mogli91/robot-competition/report/rc07.tex

%%%%%%%%%%%%%%%%%%%%%%%%%%%%%%%%%%%%%%%%%%%%%%%%%%%%%%%%%%%%%%%%%%%%%%%%%%%%%%%%
%
%   Semester project, fall term 2014
%   Author: Jakob Ehrl, born 01/24/91
%   Study program: Computer science, MA 1
%   
%   Professor Dr. Francesco Mondada
%   Assistant: Dr. Stefan Witwicki
%
%%%%%%%%%%%%%%%%%%%%%%%%%%%%%%%%%%%%%%%%%%%%%%%%%%%%%%%%%%%%%%%%%%%%%%%%%%%%%%%%%

\chapter{Schematics and Implementation}

In this section is described the connection between the different modules, voltage sources, and the signal cables.

\section{Modules connection}

The main modules are connected together, with a central processing brain, the Odroid-C1.

\begin{figure}[H]
  \centering
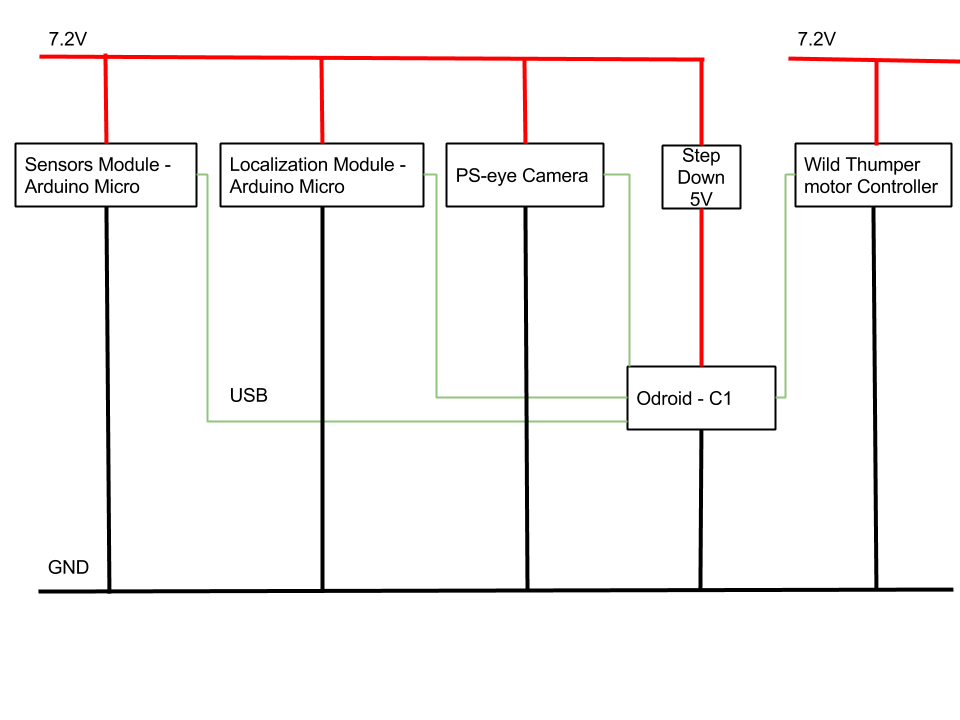
[picture p27: report/figures/GlobalConnection.png]
  
  \caption{The Global abstract connection between the different modules.}
\label{fig:GlobalConnection}
\end{figure}

In the Figure \ref{fig:GlobalConnection} above, is represented the connection diagram between the main modules. As it can be observed, the communication connections between these modules are all USB ( green wire) . This will reduce the number of cables, and ease the communication, as it is an asynchronous protocol, which is widely used and very documented for the arduinos and odroid.\\

Everything is supplied by two battery packs of 7.2 Volts, but have a common ground. The reason for decoupling the wild thumper power supply from the rest comes from the high demand in current required for the motors. This current flow can (if higher than the 10 A of the fuse) burn the fuse for in the power rack. Another reason is that the motors draw much current (2.2 Amps per motor at stall) and if the odroid is connected to the same battery it can happen that the current instability will cause the odroid to fail.

The odroid is connected to a step down voltage regulator, because it needs a stable 5 volts power supply to function correctly.

\section{Sensor Module}

The sensors module, as described in it's respective section, is connected to all the range sensors in the robot. It can also control the brush motor and the Dynamixel smart Servo. An other feature is to read the current that is flowing through the brush motor.

\begin{figure}[H]
  \centering
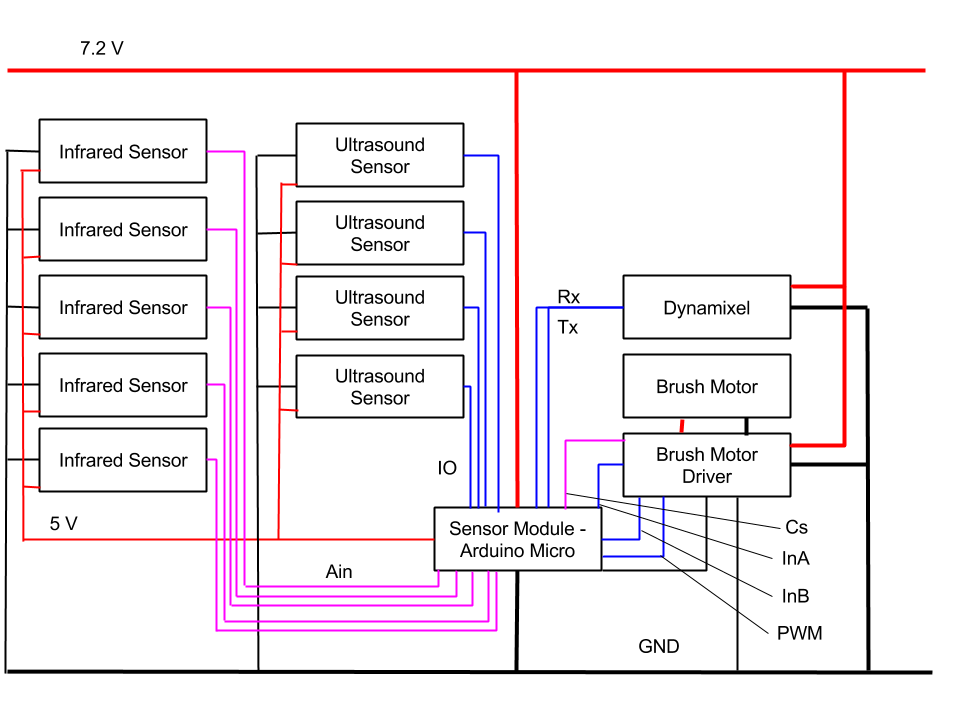
[picture p28: report/figures/Arduino1Connection.png]
  
  \caption{The Sensors module, and it's connections.}
\label{fig:ard1connection}
\end{figure}

As it can be seen in Figure \ref{fig:ard1connection} above, the sensors module is connected to many different sensors. With 20 IO pins and 12 Analog input pins, the arduino Micro is also powerful enough to read, interpred, and connect to all those sensors. In purple are all the analog wires, and blue the IO pins. The Cs is a special pin on the motor driver that allows to read the current flowing through the motor. Each 140mV read on this pin corresponds to 1 Amp on the motor. For the dynamixel, as described earlier, the two serial wires are connected together with a resistance in between to simulate a half duplex connection. The ultrasound sensors, as well have both echo and ping pins connected together with a resistance in between, in order to reduce the number of pins used on the arduino micro, and facilitate the connections.\\

The three other IO pins connected to the motor driver are just controls for the motor. The motor driver needs two power supplies. One is for the input logic, 5V, and the other is for the motor output (we used the battery 7.2 V power supply).\\

Figure \ref{fig:ard1connection} was the planned connections, but was not what was used in the end, during the competition, a more accurate figure would be Figure \ref{fig:ard1connection2} seen below, where only infrared sensors were used.

\begin{figure}[H]
  \centering
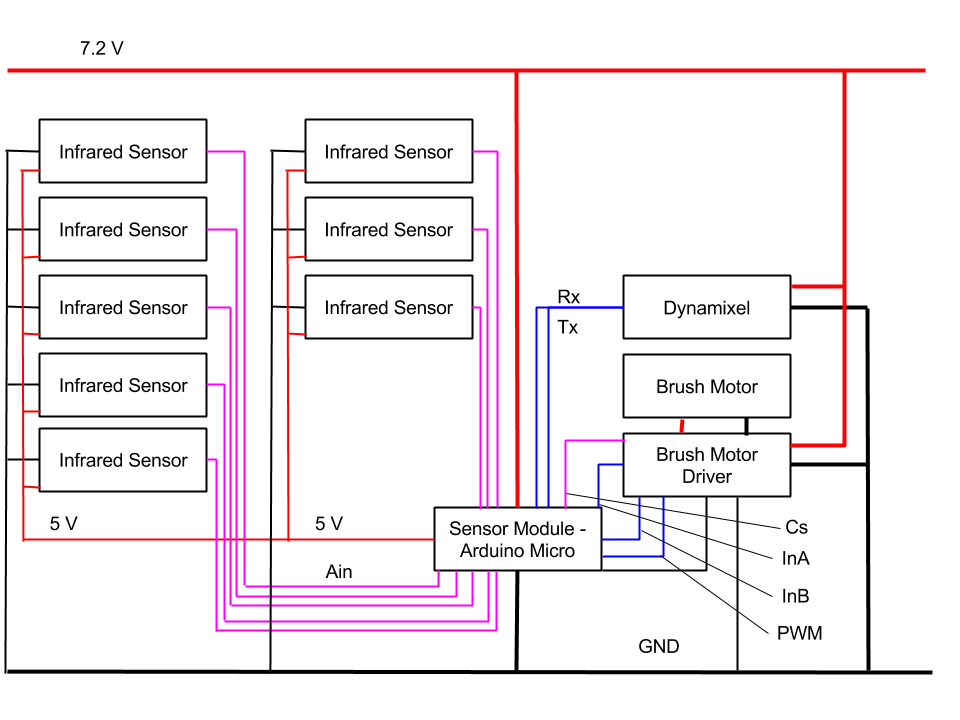
[picture p29: report/figures/Arduino1Connection2.png]
  
  \caption{The Sensors module, and it's connections.}
\label{fig:ard1connection2}
\end{figure}

\section{Localization Module}

The localization module is, as described in the section previously, the module that uses 6 line sensor arrays and a compass to locate the position and yaw of the robot. 

\begin{figure}[H]
  \centering
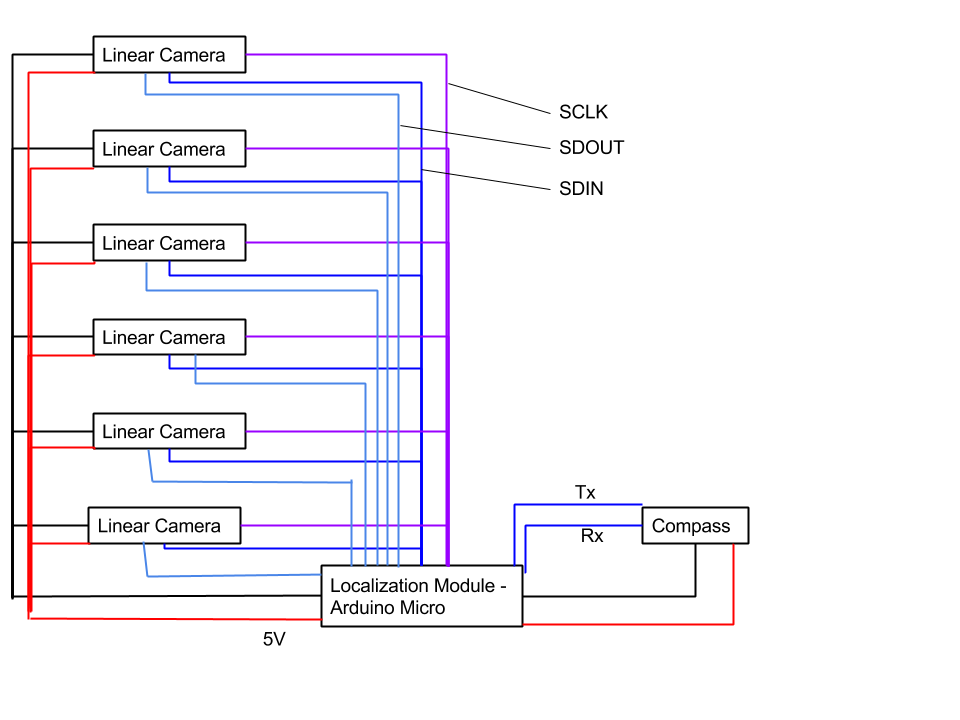
[picture p30: report/figures/Arduino2Connection.png]
  
  \caption{The Localization module, and it's connections.}
\label{fig:ard2connection}
\end{figure}

The connection between the arduino micro and the sensors is shown in the Figure \ref{fig:ard2connection} above. The compass uses a simple serial connection, and the arduino micro has two of them ( USB and serial pins). For the linear cameras, three lines were necessary. SCLK, the clock, can be common between the sensors, since it does not have any effect if no data is transmitted. %The SDIN lines are soldered together as well, XXXXXXXXXXXXXXXXXXXXXXXXXXXXXXXXXXXXXXXX
%XXXXXXXXXXXXXXXXXXXXXXXXXXXXXXXXXXXXXXXXXXX
%XXXXXXXXXXXXXXXXXXXXXXXXXXXXXXXx
%XXXXXXXXXXXXXXXXXXXXXXXXXXXXXXX
%XXXXXXXXXXXXXXXXXXXXXXXXXXXXXXX

\section{Motor driver module}

The motor driver module has very simple connections. The only devices it is controlling are the motors, and the tailgate servo.

\begin{figure}[H]
  \centering
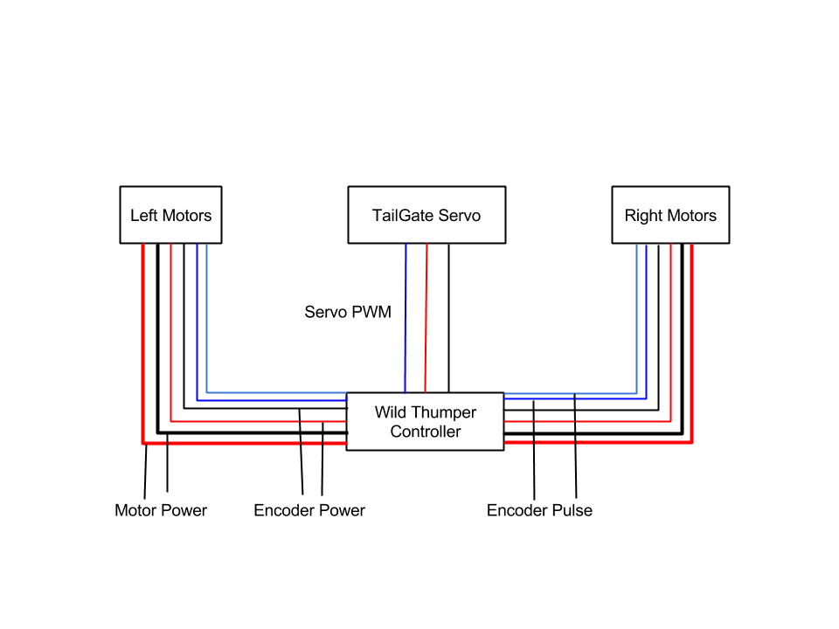
[picture p31: report/figures/WildThumperConnection.png]
  
  \caption{The Motor Driver Module, and it's connections.}
\label{fig:wtconnection}
\end{figure}

Seen in Figure \ref{fig:wtconnection} above is the connection diagram of the wild thumper motor controller. The only signals it is reading are the motor encoders, which allow to estimate a precise speed, and position of the wheels.

%\chapter{Implementation}
%how everything was connected, connectors etc.. battery... 

\chapter{Results}
The robot was the second one in the competition. With 2.5 poits, the robot was able to capture a bottle and nearly bring it back in time. The remote control from a computer allowed us to control manually all the functions of the robot, the wheels, the servos, and the brush, and we were also able to visualize the camera, and see the values of all the different sensors. The robot was able to navigate towards a bottle, to avoid obstacles, and was also able to return home and open the tailgate. However, as many false positives were measured from the camera, the robot sometimes saw beacons, and thus released the bottles. Another feature was area distinction, which allowed the robot to avoid going in dangerous zones, but there, once again, the false positives would make the robot go towars the rocks for instance. As the shovel was close to the ground, the robot sometimes got stuck in between the tiles, under the grass or the rocks. In the beginning it was planned to use two dynamixels, because one was not strong enough to just `hover' the lift above the ground, but since the synchronization of the servos failed, we could only have two states : on the ground or lifted all the way.

\chapter{Conclusion and Acknowledgments}

\section{Conclusion}
Finally, this huge project took a tremendous amount of our time. In order to accomplish a functionnal robot, nearly every day was spend in epfl until midnight, where intense work took place. It was quite sad to obtain a robot that did not manage to bring back more than one bottle at the end, especially considering the amount of work invested in the project. However, all this work allowed us to learn very much on the design, construction and programming of a robot, with all the project phases in between, as well as team management, working together and programming together. All the theory behind the building of a robot was already known, but assembling it and testing it gave us a whole new insight about all the problems that can occur during such a large project, and how to deal with them, solve them. Problems that are not only with the hardware, or the software, but also in the group itself. \\

\section{Acknowledgments}
We would like to thank our assistant Tomasz, for all the help and support during the competition, as well as all the other assitants that were always available for some questions. We would like to thank as well Alessandro Crespi, who was always available for purchases, maintenance of the machines, and his advice. We would also want to thank Mr. Lispjeert and all the team behind this semester project, whithout whom it would not be possible. Finally, we would like to thank all the other groups for their support, help, friendliness, all the good times that we had toghether in the lab, and all the barbecues that we had. This competition was for us more of a `friendly' contest between friends, rather than a cold and unfriendly competition. If we could recommend this semester project for future students we would ( and already have...).

\chapter{Annex}

\begin{figure}[H]
  \centering
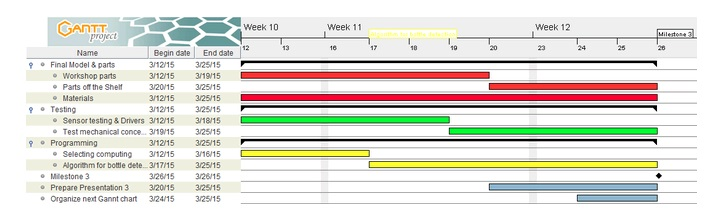
[picture p32: report/figures/GanttChart1.jpg]
  
  \caption{Gannt Chart until the third milestone.}
\label{fig:gannt1}
\end{figure}

\begin{figure}[H]
  \centering
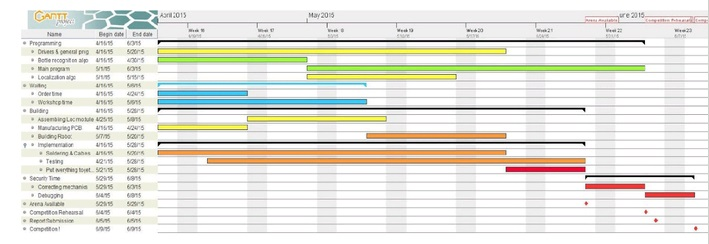
[picture p33: report/figures/GanttChart2.jpg]
  
  \caption{Gannt Chart until the end of the competition.}
\label{fig:gannt2}
\end{figure}

\begin{figure}[H]
  \centering
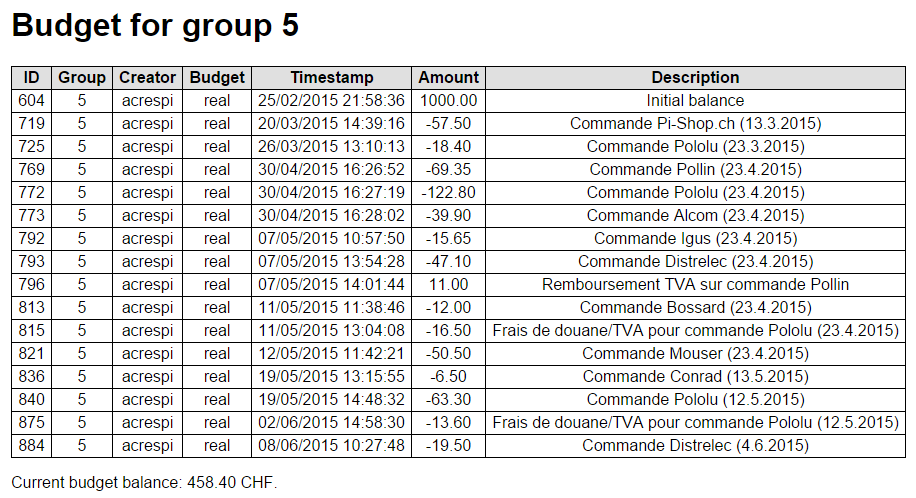
[picture p34: report/figures/budgetreal.png]
  
  \caption{Real budget used for the robot.}
\label{fig:real}
\end{figure}

\begin{figure}[H]
  \centering
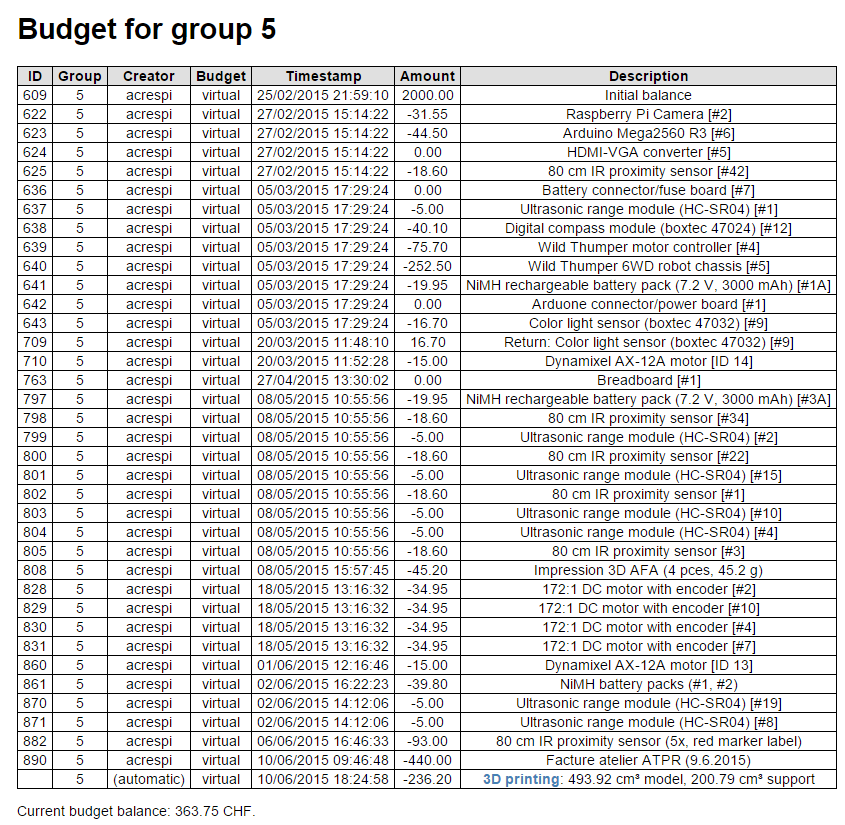
[picture p35: report/figures/budgetvirtual.png]
  
  \caption{Virtual budget used for the robot.}
\label{fig:virtual}
\end{figure}
