mogli91/robot-competition/sketchbook/ArduinoMicro1/Used Pins.txt

Arduino micro - capteurs et moteur

20 pins IO - 7 PWM, 12 AI 

Infrarouges 
IR gauche - A0
IR devant côté gauche - A1
IR devant côté droit - A2
IR droite - A3
IR derrière - A4

Ultrasons
US gauche - pin 2
US devant côté gauche - pin 3
US devant côté droit - pin 4
US droite - pin 5

Moteur de rouleau (driver = https://www.pololu.com/product/1451)
CS (currnt sense - 140mv per amp) - Pin 12 = A11
PWM (motor control) - pin 11
INA (clockwise direction) - pin 9 
INB (counterclocwise direction) - pin 10
ENA - not connected
ENB - not connected
CS_DIS - not connected

Serial connection : 
RX : pin 0
TX : pin 1
