mogli91/robot-competition/report/rc00.tex

%%%%%%%%%%%%%%%%%%%%%%%%%%%%%%%%%%%%%%%%%%%%%%%%%%%%%%%%%%%%%%%%%%%%%%%%%%%%%%%%
%
%   Semester project, fall term 2014
%   Author: Jakob Ehrl, born 01/24/91
%   Study program: Computer science, MA 1
%   
%   Professor Dr. Francesco Mondada
%   Assistant: Dr. Stefan Witwicki
%
%%%%%%%%%%%%%%%%%%%%%%%%%%%%%%%%%%%%%%%%%%%%%%%%%%%%%%%%%%%%%%%%%%%%%%%%%%%%%%%%%

\input{header}

\includeonly{rc01, rc02, rc03, rc04, rc05, rc06, rc07, rc-lit, rc-lof, rc-lot}

\begin{document}

\clearpage
  \begin{deckblatt}
    \Titel{STI Robot competition}
    \NameA{Ehrl}
    \VornameA{Jakob}
    \NameB{Longobardi}
    \VornameB{Pasquale}
    \NameC{Unnervik}
    \VornameC{Eric}
   \Betreuer{Tomasz Gorecki}
    \Start{February 22nd 2015}
    \Ende{June 5th 2015}
  \end{deckblatt}

%\cleardoublepage

\begin{center}
\bfseries
Abstract
\normalfont
\end{center}
This report presents in detail the phases that have brought to the realization of a mobile, autonomous robot conceived to participate to the STI Robot Competition 2015 . This competition aims to allow student at master level to come up with solutions, for a recycling robot for PET bottles collection and transport in a reserved area, dealing with the difficulties coming from a challenging environment such as complex terrains and obtacles. The participation to this competition, as fulfillment of the master’s semester project for our team, involved the complete design of the robotic system in every aspect from hardware to software allowing us to face all the usual challenges that are encountered through the achievement of such a project. The design of the mechanical parts has been coupled with the choice of sensors and actuators exploited by developing algorithms in order to achieve perception, actuation, navigation and localization tasks that gave to the robot the necessary skills to take part in the competition.

%\cleardoublepage
\clearpage

\tableofcontents

%\cleardoublepage
\clearpage

\pagenumbering{arabic}

\include{rc01}   
%\cleardoublepage
%\clearpage
\include{rc02}   % (\chapter{})
%\cleardoublepage
\include{rc03}   % (\chapter{})
%\cleardoublepage
\include{rc04}   % (\chapter{})
%\cleardoublepage
\include{rc05}   % (\chapter{})
%\cleardoublepage
\include{rc06}   % (\chapter{})
%\cleardoublepage
\include{rc07}   % (\chapter{})
%\cleardoublepage
%\include{rc08}   % Zusammenfassung (\chapter{Zusammenfassung}  TEXT)
%\cleardoublepage

%\appendix
%\cleardoublepage
%\include{rc09}   % Glossar (\chapter{Glossar}  TEXT)
%\cleardoublepage
%\include{rc10}   % 
%\cleardoublepage
%\include{rc11}   % 
%\cleardoublepage

\include{rc-lof} % Bilderverzeichnis
%%\cleardoublepage
%%\clearpage
%\include{rc-lot} % Tabellenverzeichnis
%%\cleardoublepage
%%\clearpage
\include{rc-lit} % Literaturverzeichnis

\end{document}
