mogli91/robot-competition/report/tikz-pictures.pdf

i

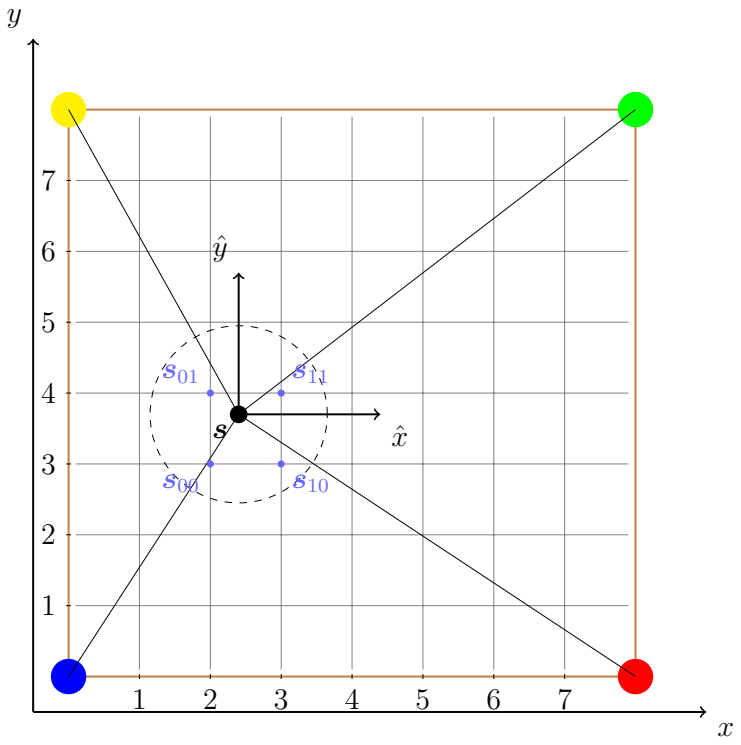
[picture p50: figure]
