mogli91/robot-competition/report/figures/alternative.pdf

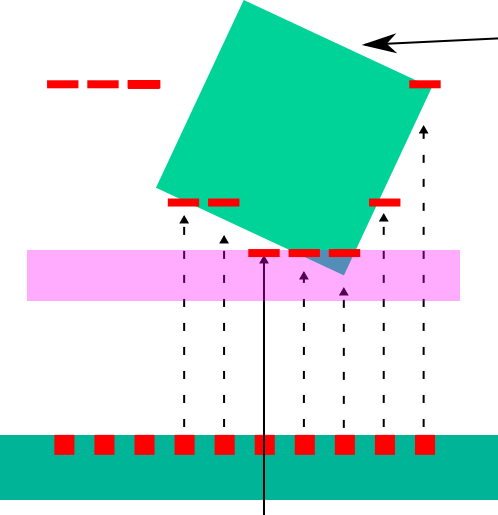
[picture p51: figure]
