mogli91/robot-competition/report/figures/alternative_for_presentation.pdf

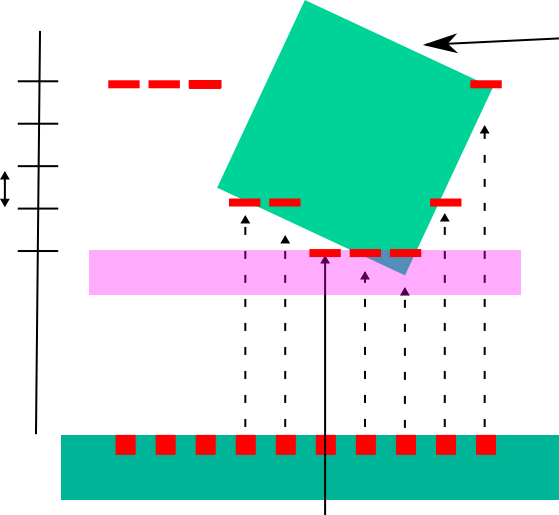
[picture p52: figure]
