mogli91/robot-competition/report/figures/marxbot.pdf

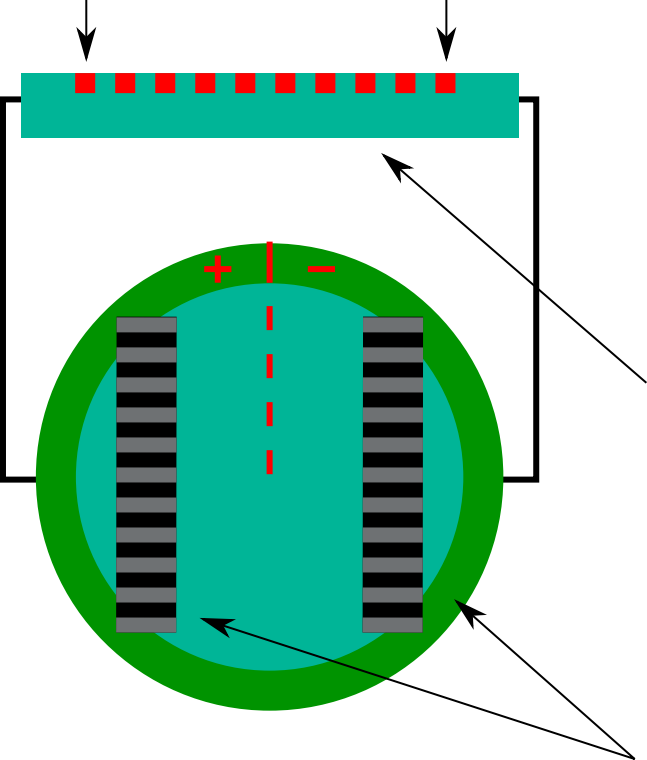
[picture p53: figure]
