mogli91/robot-competition/report/figures/reward.pdf

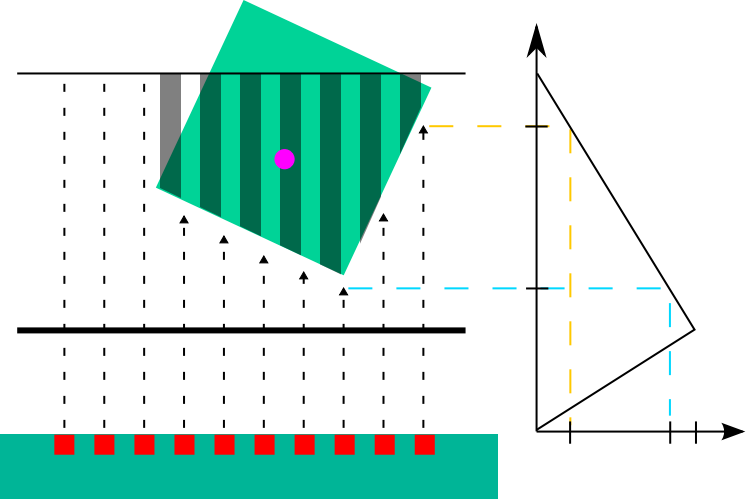
[picture p54: figure]
