mogli91/robot-competition/report/figures/s_min_mu.pdf

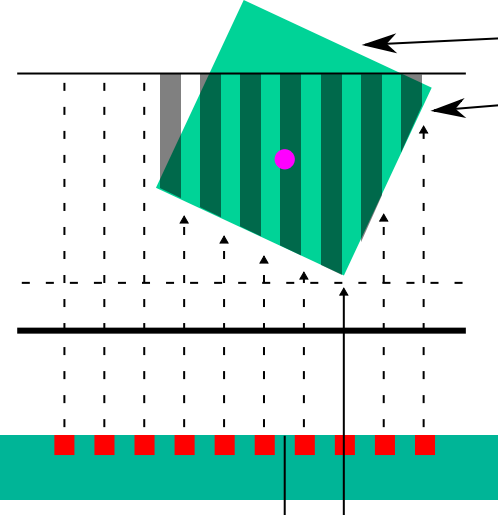
[picture p55: figure]
