mogli91/robot-competition/report/figures/009-mask.png

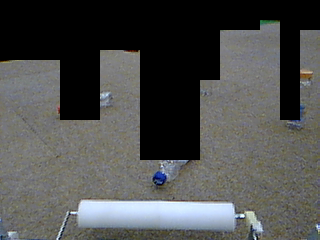
report/figures/009-mask.png
