mogli91/robot-competition/report/figures/AdjustableHeight1.JPG

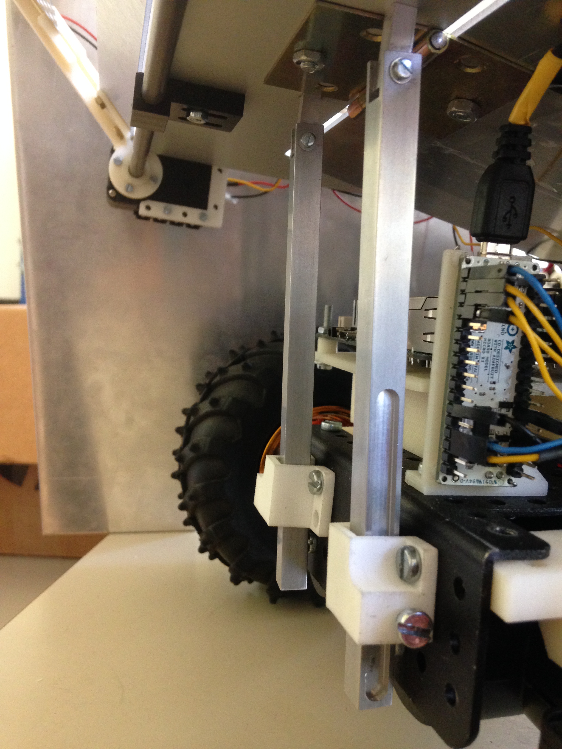
report/figures/AdjustableHeight1.JPG
