mogli91/robot-competition/report/figures/arduino.jpg

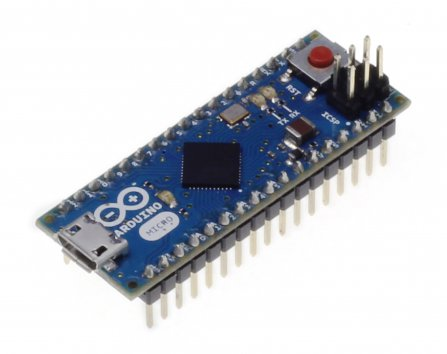
report/figures/arduino.jpg
