mogli91/robot-competition/report/figures/box1.png

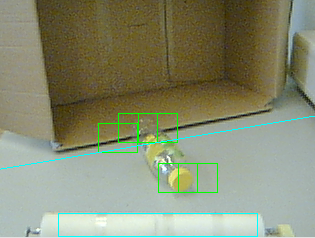
report/figures/box1.png
