mogli91/robot-competition/report/figures/box2.png

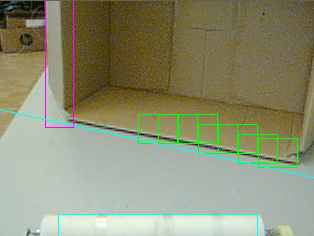
report/figures/box2.png
