mogli91/robot-competition/report/figures/compass.jpg

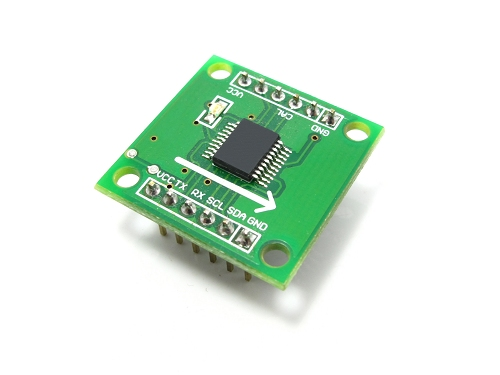
report/figures/compass.jpg
