mogli91/robot-competition/report/figures/connector.jpg

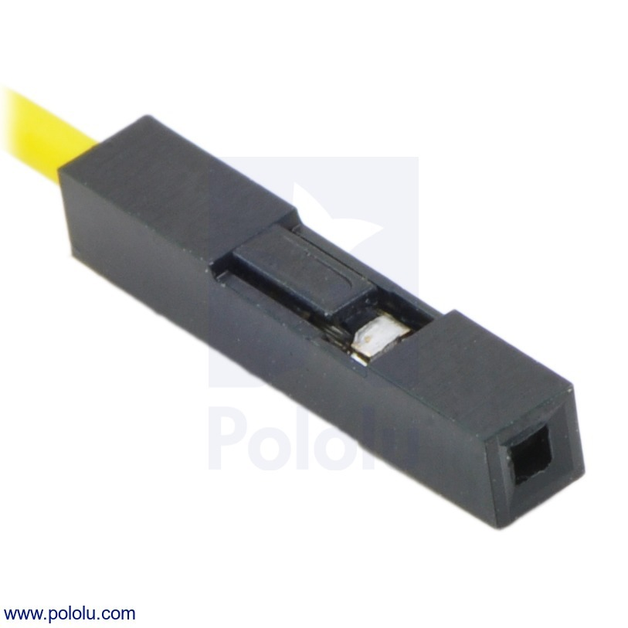
report/figures/connector.jpg
