mogli91/robot-competition/report/figures/FSM.jpg

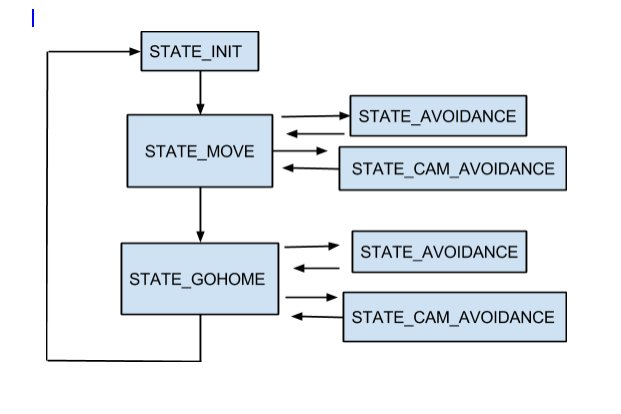
report/figures/FSM.jpg
