mogli91/robot-competition/report/figures/histograms.png

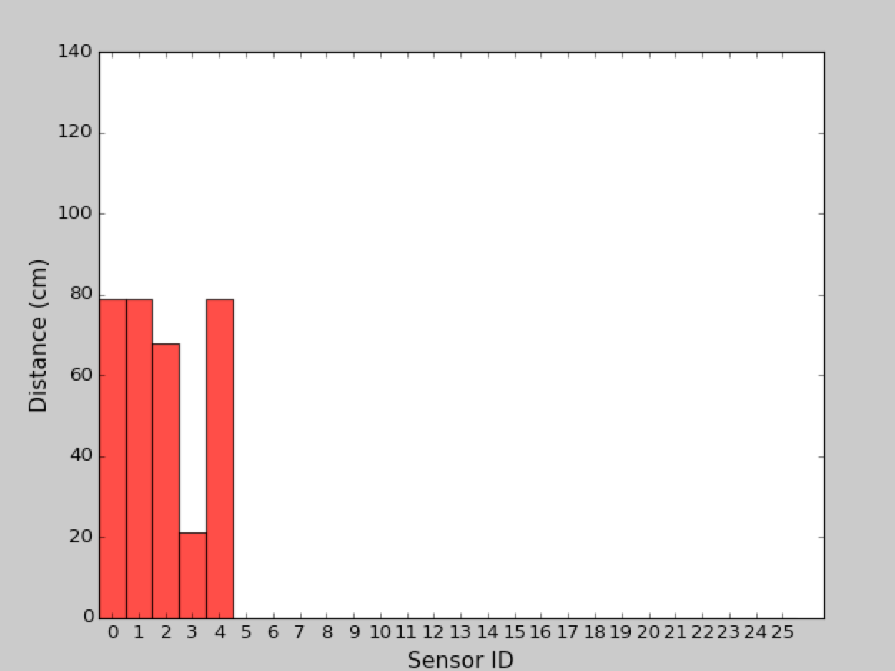
report/figures/histograms.png
