mogli91/robot-competition/report/figures/motor.jpg

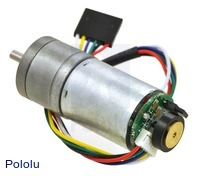
report/figures/motor.jpg
