mogli91/robot-competition/report/figures/pseye.jpg

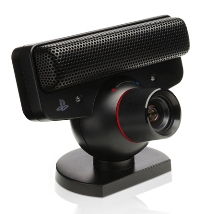
report/figures/pseye.jpg
