mogli91/robot-competition/report/figures/regulator.jpg

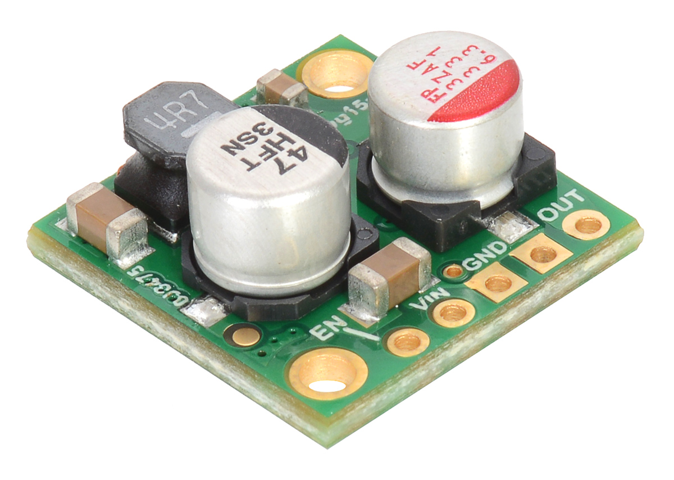
report/figures/regulator.jpg
