mogli91/robot-competition/report/figures/wtc.jpg

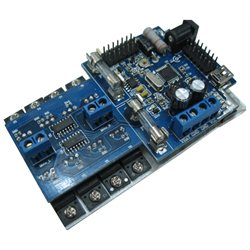
report/figures/wtc.jpg
