mogli91/robot-competition/vision/pics/0001.png

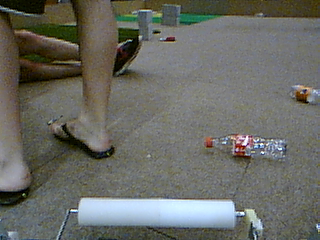
vision/pics/0001.png
