mogli91/robot-competition/vision/pics/0003.png

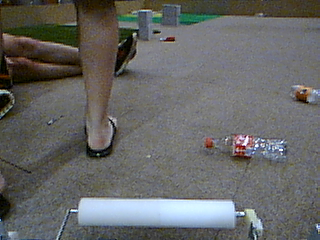
vision/pics/0003.png
