mogli91/robot-competition/vision/pics/0004.png

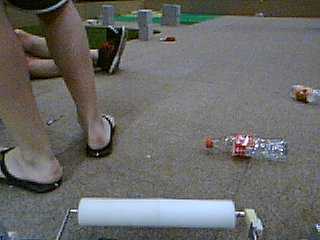
vision/pics/0004.png
