mogli91/robot-competition/vision/pics/0005.png

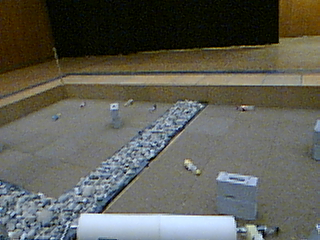
vision/pics/0005.png
