mogli91/robot-competition/vision/pics/0006.png

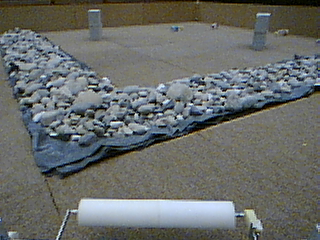
vision/pics/0006.png
