mogli91/robot-competition/vision/pics/0007.png

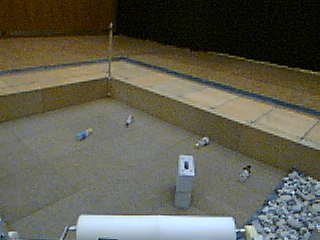
vision/pics/0007.png
