mogli91/robot-competition/vision/pics/0008.png

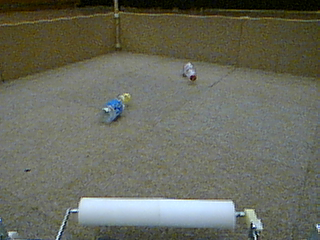
vision/pics/0008.png
