mogli91/robot-competition/vision/pics/0009.png

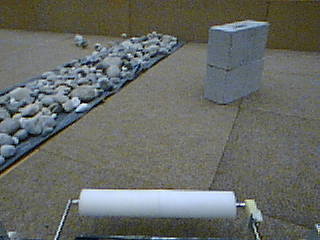
vision/pics/0009.png
