mogli91/robot-competition/vision/pics/0010.png

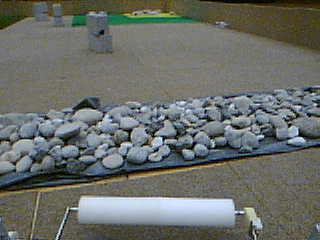
vision/pics/0010.png
