mogli91/robot-competition/vision/pics/0011.png

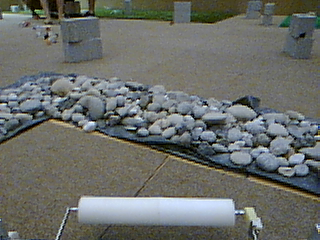
vision/pics/0011.png
