mogli91/robot-competition/vision/pics/0012.png

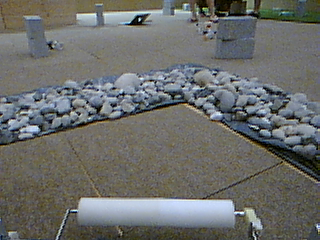
vision/pics/0012.png
