mogli91/robot-competition/vision/pics/0013.png

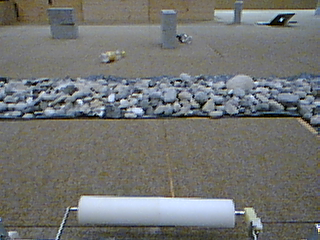
vision/pics/0013.png
