mogli91/robot-competition/vision/pics/0014.png

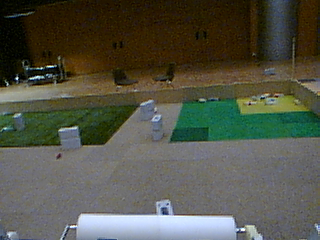
vision/pics/0014.png
