mogli91/robot-competition/vision/pics/0015.png

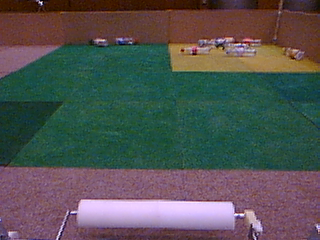
vision/pics/0015.png
