mogli91/robot-competition/vision/pics/0016.png

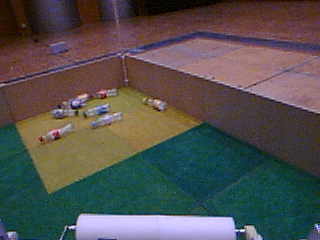
vision/pics/0016.png
