mogli91/robot-competition/vision/pics/0017.png

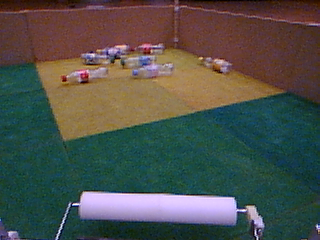
vision/pics/0017.png
