mogli91/robot-competition/vision/pics/0018.png

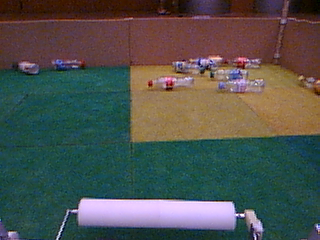
vision/pics/0018.png
