mogli91/robot-competition/vision/pics/0020.png

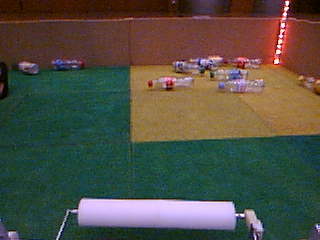
vision/pics/0020.png
