mogli91/robot-competition/vision/pics/0021.png

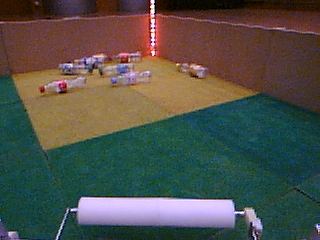
vision/pics/0021.png
