mogli91/robot-competition/vision/pics/0022.png

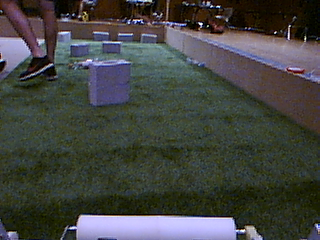
vision/pics/0022.png
