mogli91/robot-competition/vision/pics/0023.png

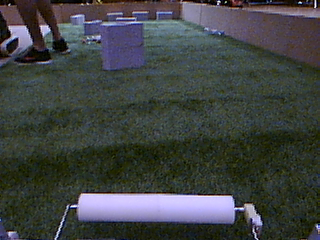
vision/pics/0023.png
