mogli91/robot-competition/vision/pics/0024.png

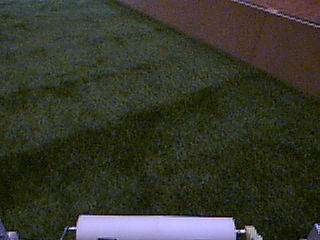
vision/pics/0024.png
