mogli91/robot-competition/vision/pics/0025.png

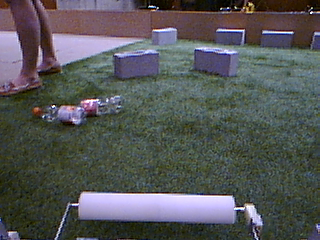
vision/pics/0025.png
