mogli91/robot-competition/vision/pics/0026.png

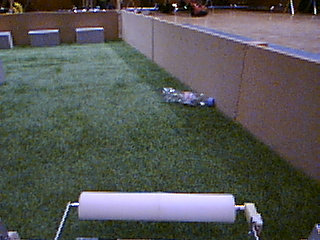
vision/pics/0026.png
