mogli91/robot-competition/vision/pics/0027.png

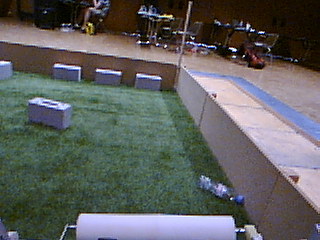
vision/pics/0027.png
