mogli91/robot-competition/vision/pics/0028.png

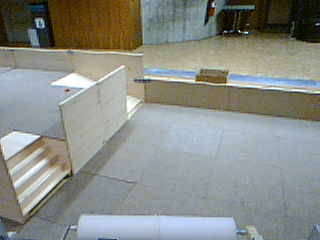
vision/pics/0028.png
