mogli91/robot-competition/vision/pics/0031.png

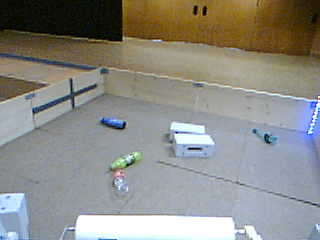
vision/pics/0031.png
