mogli91/robot-competition/vision/pics/0032.png

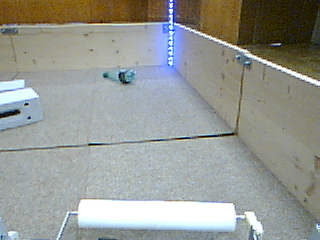
vision/pics/0032.png
