mogli91/robot-competition/vision/pics/0033.png

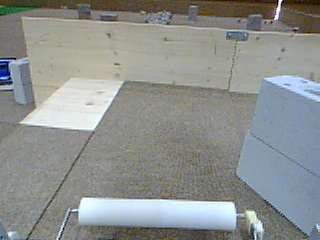
vision/pics/0033.png
