mogli91/robot-competition/vision/pics/0034.png

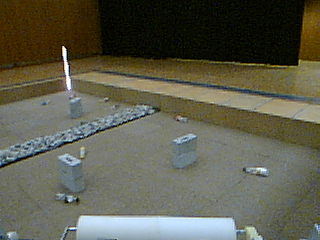
vision/pics/0034.png
