mogli91/robot-competition/vision/pics/0035.png

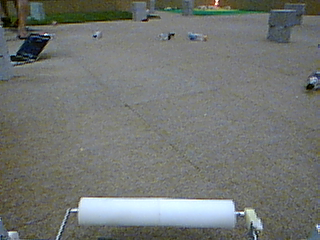
vision/pics/0035.png
