mogli91/robot-competition/vision/pics/0037.png

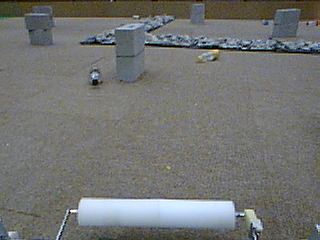
vision/pics/0037.png
