mogli91/robot-competition/vision/pics/0038.png

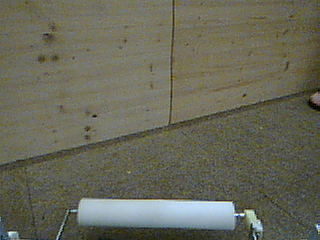
vision/pics/0038.png
