mogli91/robot-competition/vision/pics/0040.png

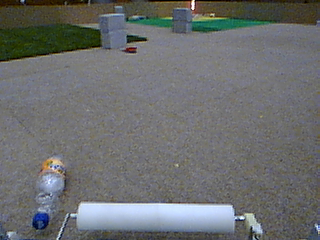
vision/pics/0040.png
