mogli91/robot-competition/vision/pics/0042.png

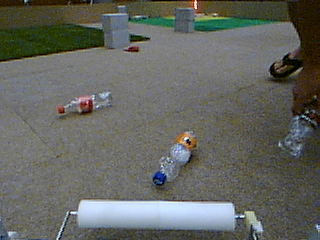
vision/pics/0042.png
