mogli91/robot-competition/vision/pics/0043.png

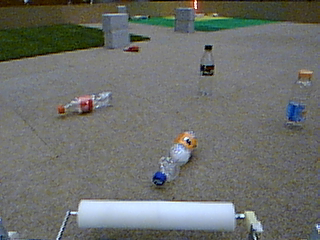
vision/pics/0043.png
