mogli91/robot-competition/vision/pics/0044.png

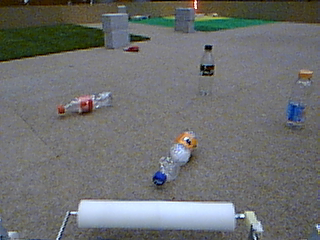
vision/pics/0044.png
