mogli91/robot-competition/vision/pics/guvcview_image-1.jpg

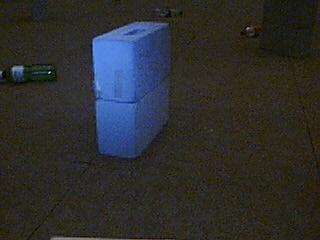
vision/pics/guvcview_image-1.jpg
