mogli91/robot-competition/vision/pics/guvcview_image-3.jpg

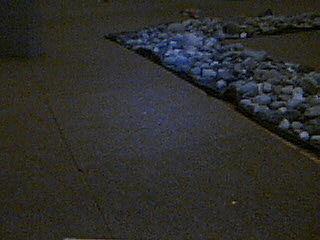
vision/pics/guvcview_image-3.jpg
