mogli91/robot-competition/vision/pics/guvcview_image-4.jpg

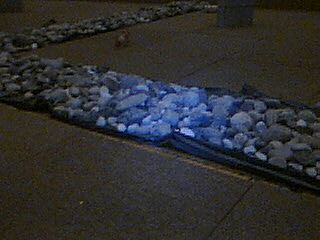
vision/pics/guvcview_image-4.jpg
