mogli91/robot-competition/vision/pics/guvcview_image-5.jpg

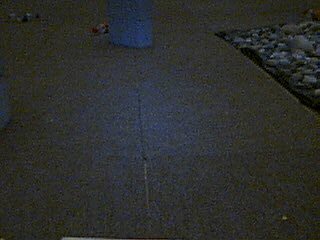
vision/pics/guvcview_image-5.jpg
