mogli91/robot-competition/vision/pics/guvcview_image-6.jpg

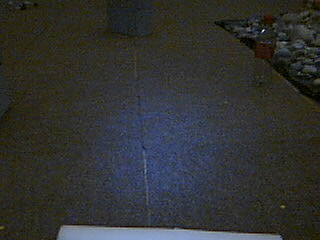
vision/pics/guvcview_image-6.jpg
