mogli91/robot-competition/vision/pics/guvcview_image-8.jpg

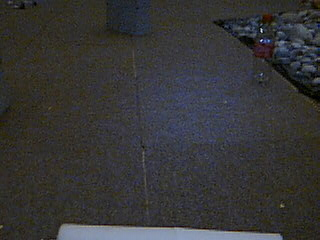
vision/pics/guvcview_image-8.jpg
