mogli91/robot-competition/vision/pics/guvcview_image-9.jpg

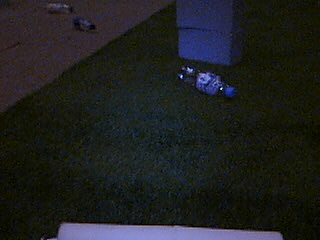
vision/pics/guvcview_image-9.jpg
