mogli91/robot-competition/vision/pics/guvcview_image-10.jpg

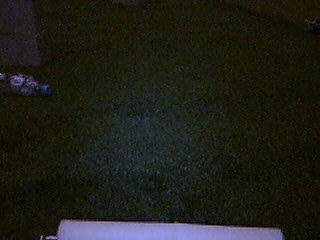
vision/pics/guvcview_image-10.jpg
