mogli91/robot-competition/vision/pics/guvcview_image-12.jpg

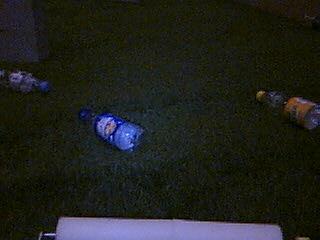
vision/pics/guvcview_image-12.jpg
