mogli91/robot-competition/vision/pics/guvcview_image-13.jpg

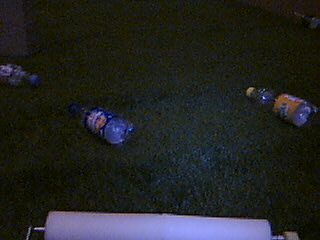
vision/pics/guvcview_image-13.jpg
