mogli91/robot-competition/vision/pics/guvcview_image-14.jpg

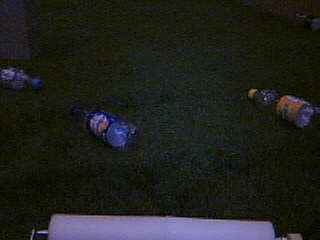
vision/pics/guvcview_image-14.jpg
