mogli91/robot-competition/vision/pics/guvcview_image-15.jpg

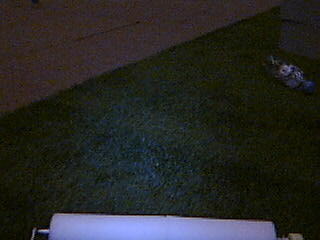
vision/pics/guvcview_image-15.jpg
