mogli91/robot-competition/vision/pics/guvcview_image-16.jpg

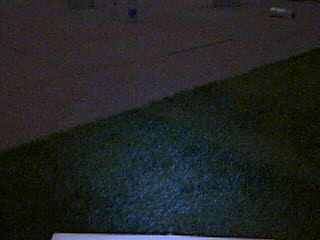
vision/pics/guvcview_image-16.jpg
