mogli91/robot-competition/vision/pics/guvcview_image-17.jpg

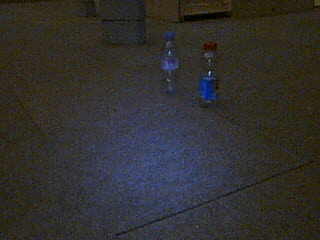
vision/pics/guvcview_image-17.jpg
