mogli91/robot-competition/vision/pics/guvcview_image-18.jpg

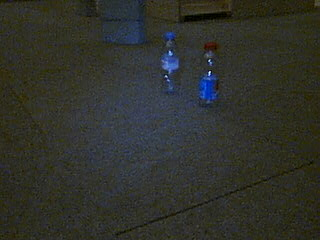
vision/pics/guvcview_image-18.jpg
