mogli91/robot-competition/vision/pics/guvcview_image-19.jpg

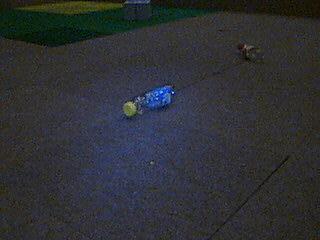
vision/pics/guvcview_image-19.jpg
