mogli91/robot-competition/vision/pics/guvcview_image-21.jpg

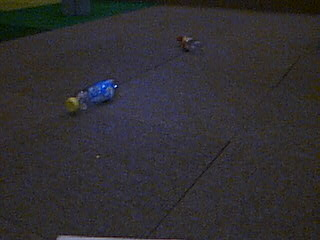
vision/pics/guvcview_image-21.jpg
