mogli91/robot-competition/vision/pics/guvcview_image-22.jpg

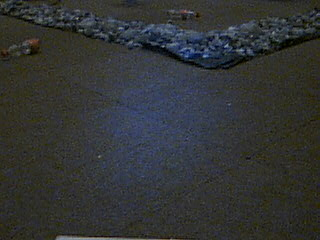
vision/pics/guvcview_image-22.jpg
