mogli91/robot-competition/vision/pics/guvcview_image-23.jpg

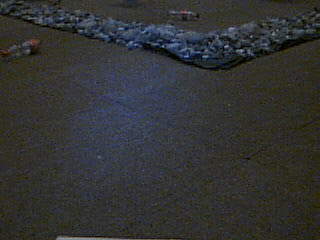
vision/pics/guvcview_image-23.jpg
