mogli91/robot-competition/vision/pics/guvcview_image-24.jpg

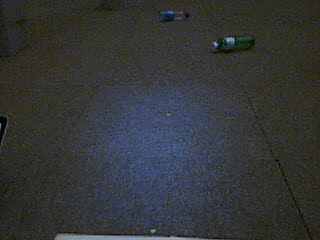
vision/pics/guvcview_image-24.jpg
