mogli91/robot-competition/vision/pics/guvcview_image-25.jpg

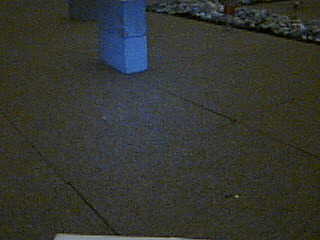
vision/pics/guvcview_image-25.jpg
