mogli91/robot-competition/vision/pics/guvcview_image-26.jpg

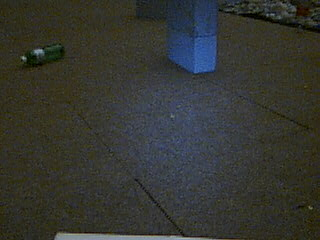
vision/pics/guvcview_image-26.jpg
