mogli91/robot-competition/vision/pics/guvcview_image-27.jpg

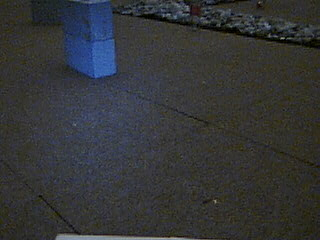
vision/pics/guvcview_image-27.jpg
