mogli91/robot-competition/vision/pics/guvcview_image-28.jpg

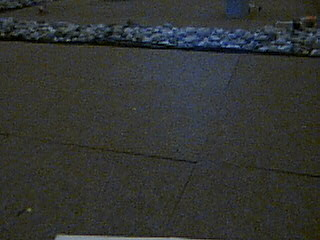
vision/pics/guvcview_image-28.jpg
