mogli91/robot-competition/vision/pics/guvcview_image-29.jpg

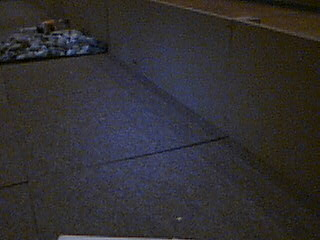
vision/pics/guvcview_image-29.jpg
