mogli91/robot-competition/vision/pics/guvcview_image-30.jpg

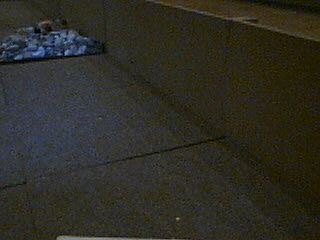
vision/pics/guvcview_image-30.jpg
