mogli91/robot-competition/vision/pics/masked.png

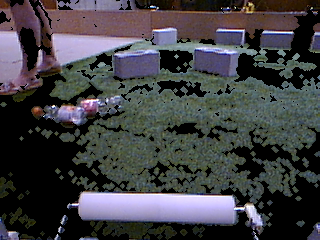
vision/pics/masked.png
