mogli91/robot-competition/report/figures/experiment_plan.pdf

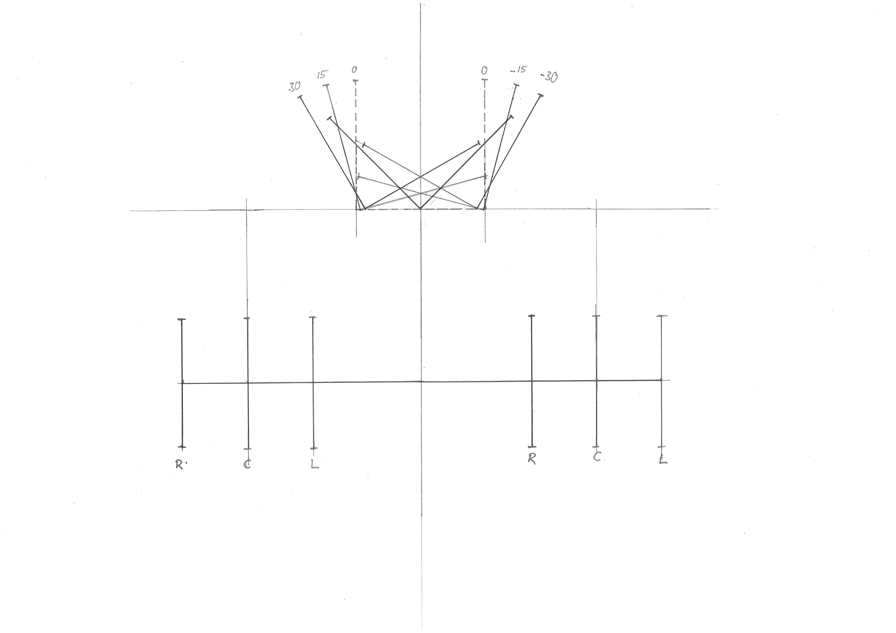
[picture p133: page 1]
