mogli91/robot-competition/report/figures/fig_localization_grid.pdf

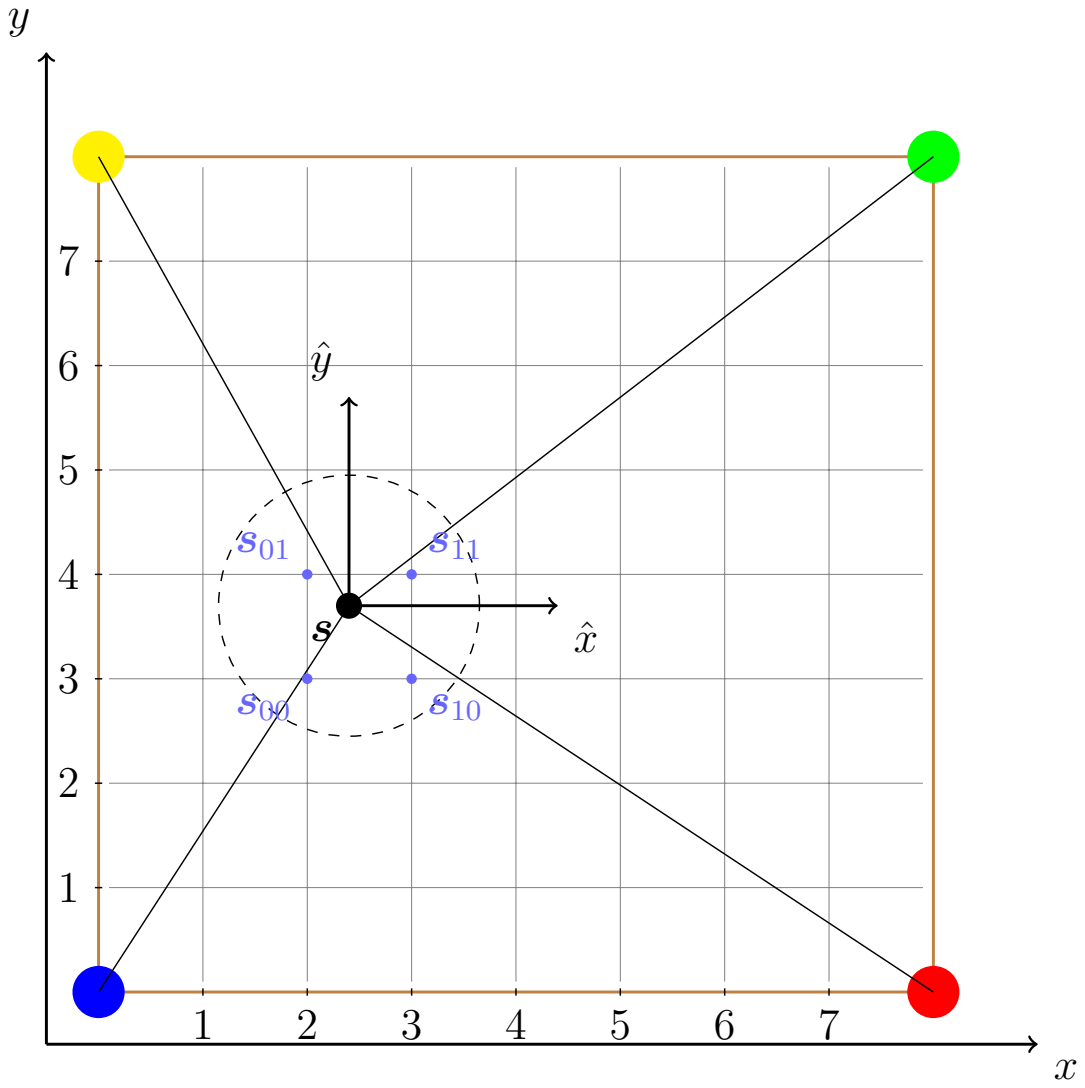
[picture p134: page 1]
