mogli91/robot-competition/sketchbook/WTC/IOpins.h

#define LmotorA             3  // Left  motor H bridge, input A
#define LmotorB            11  // Left  motor H bridge, input B
#define RmotorA             5  // Right motor H bridge, input A
#define RmotorB             6  // Right motor H bridge, input B

#define RCleft              0  // Digital input 0
#define RCright             1  // Digital input 1

#define SERVO               8  // Servo output

#define Battery             0  // Analog input 00
#define RmotorC             6  // Analog input 06
#define LmotorC             7  // Analog input 07
#define Charger            13  // Low=ON High=OFF



/*Wild thumper controller - roues, servos
configuration for the pins : outside = GND middle = VCC (5V) inside = pin

encoders :
left : D12, D10
right : D2, D4

servo :
D8

dynamixel 
D0, D1*/
