mogli91/robot-competition/sketchbook/ArduinoMicro2_Compass/prior.h

#ifndef PRIOR_H
#define PRIOR_H

#include "Arduino.h"

// localization variables
#define NUM_PX 612
#define NUM_BEACONS 4
#define NUM_ANGLES 360

#define WORLDX 800
#define WORLDY 800

#define TILEX 50
#define TILEY 50

const int NUM_X = WORLDX/TILEX + 1;
const int NUM_Y = WORLDY/TILEY + 1;

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

#endif
