mogli91/robot-competition/(commit log)

2015-06-06 pasquale's simulation files and arduino
2015-06-07 obstacle avoidance state machine
    [simulation.cpp, simulation.h]
2015-06-09 timer implemented
2015-06-09 arduino timer function
