mogli91/robot-competition/report/figures/remote.jpg

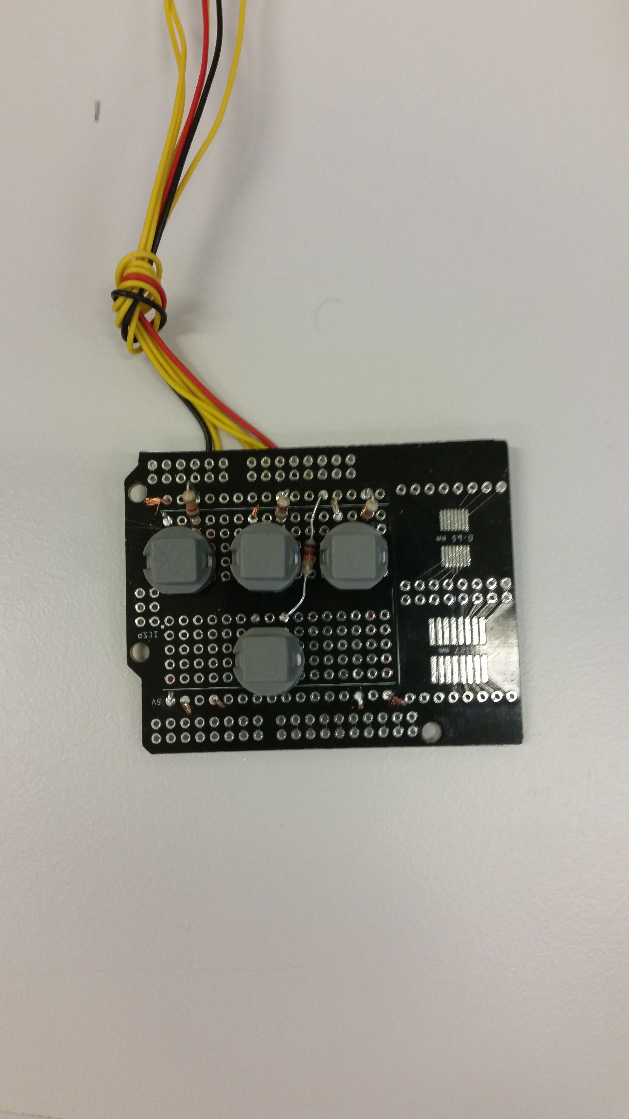
[picture p43: report/figures/remote.jpg]
report/figures/remote.jpg
